TinyCircuits/TinyCircuits-TinyLily_USB-ASL2111/README.md

# TinyCircuits-TinyLily_USB-ASL2111
TinyCircuits TinyLily Mini USB Board, Model ASL2111

For FTDI USB drivers, go to: https://www.ftdichip.com/FTDrivers.htm
