TinyCircuits/TinyCircuits-TinyLily_USB-ASL2111/cad/TinyLily_USB_ASL2111_REV4-DETAILED_DRAWING-PNG.png

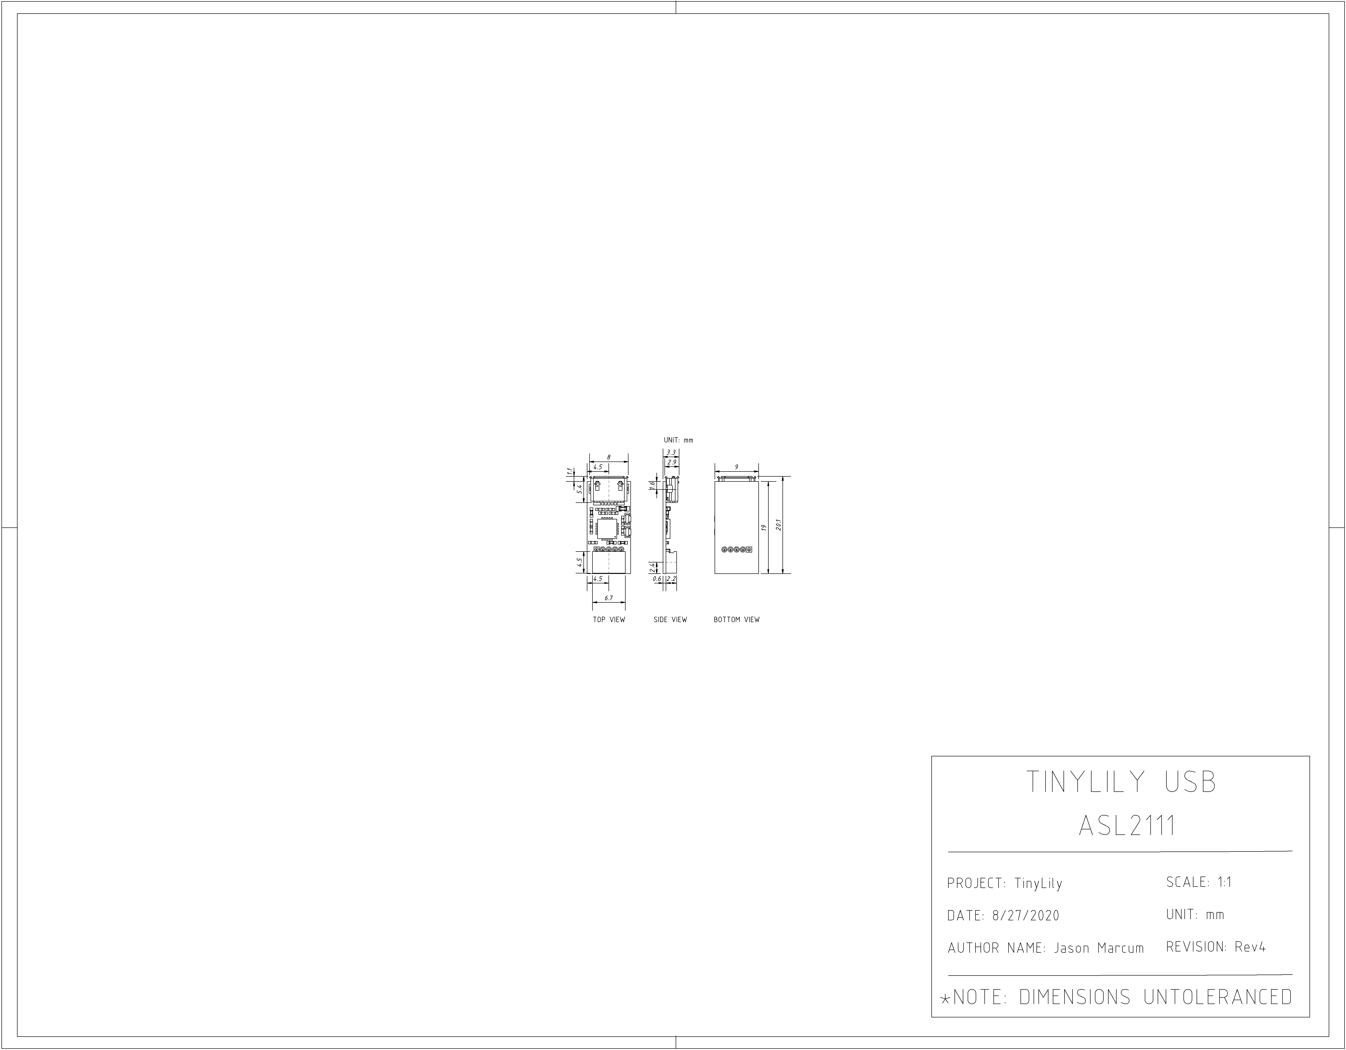
cad/TinyLily_USB_ASL2111_REV4-DETAILED_DRAWING-PNG.png
