TinyCircuits/TinyCircuits-TinyLily_USB-ASL2111/cad/TinyLily_USB_ASL2111_REV4-STL.stl

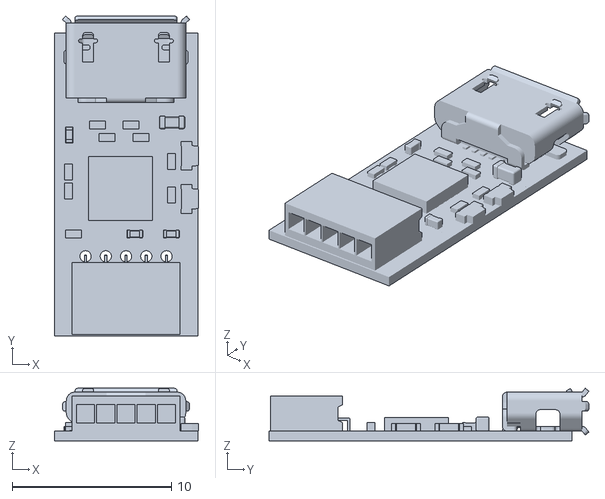
[picture p3: CAD file, 2020-08-28]
cad/TinyLily_USB_ASL2111_REV4-STL.stl
9.06 x 20.1 x 3.30
