TinyCircuits/TinyCircuits-TinyLily_USB-ASL2111/cad/TinyLily_USB_ASL2111_REV4-DETAILED_DRAWING-DXF.dxf

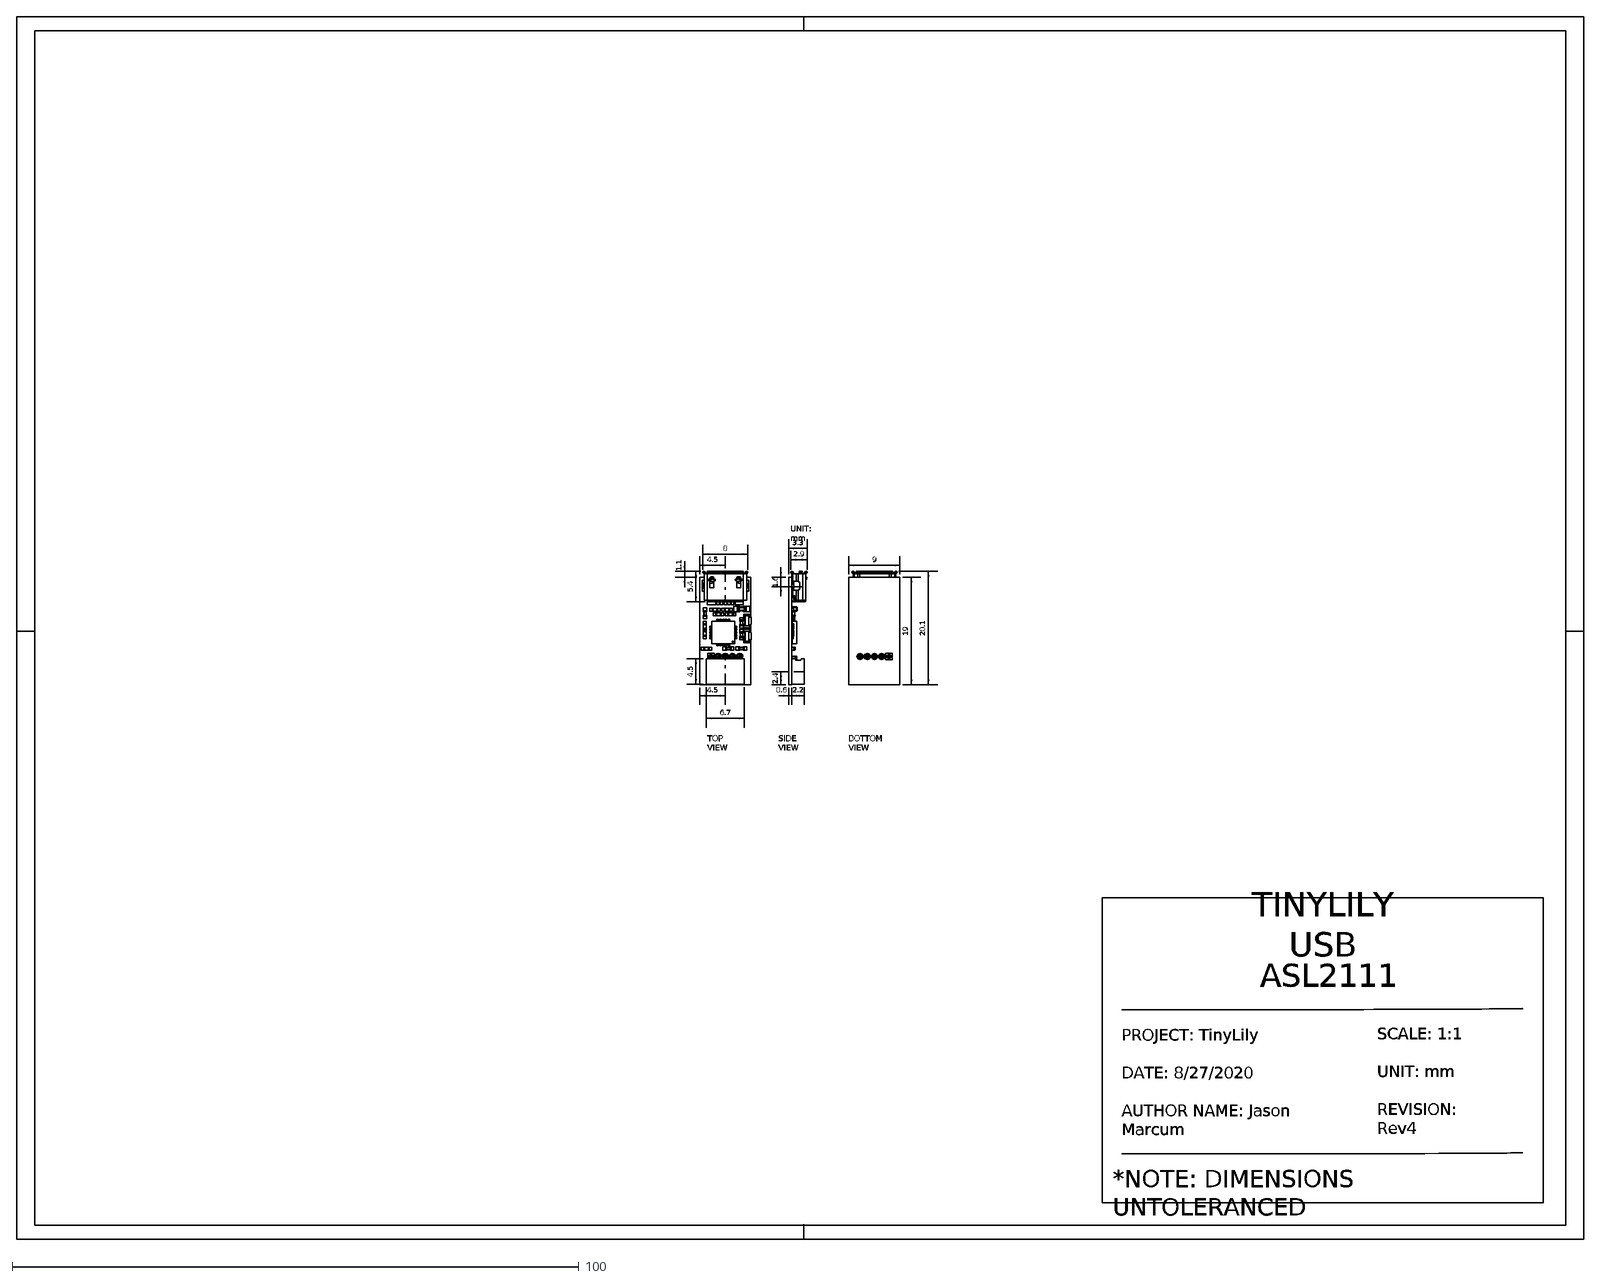
[picture p4: CAD file, 2020-08-28]
cad/TinyLily_USB_ASL2111_REV4-DETAILED_DRAWING-DXF.dxf
*NOTE: DIMENSIONS UNTOLERANCED
4.5
8
5.4
6.7
BOTTOM VIEW
SIDE VIEW
TOP VIEW
1.6
1.1
2.9
2.2
2.4
3.3
0.6
9
19
20.1
UNIT: mm
TINYLILY USB
ASL2111
PROJECT: TinyLily DATE: 8/27/2020 AUTHOR NAME: Jason Marcum
SCALE: 1:1 UNIT: mm REVISION: Rev4
