TinyCircuits/TinyCircuits-TinyLily_USB-ASL2111/design_files/TinyLily_Mini_USB_Rev4.pdf

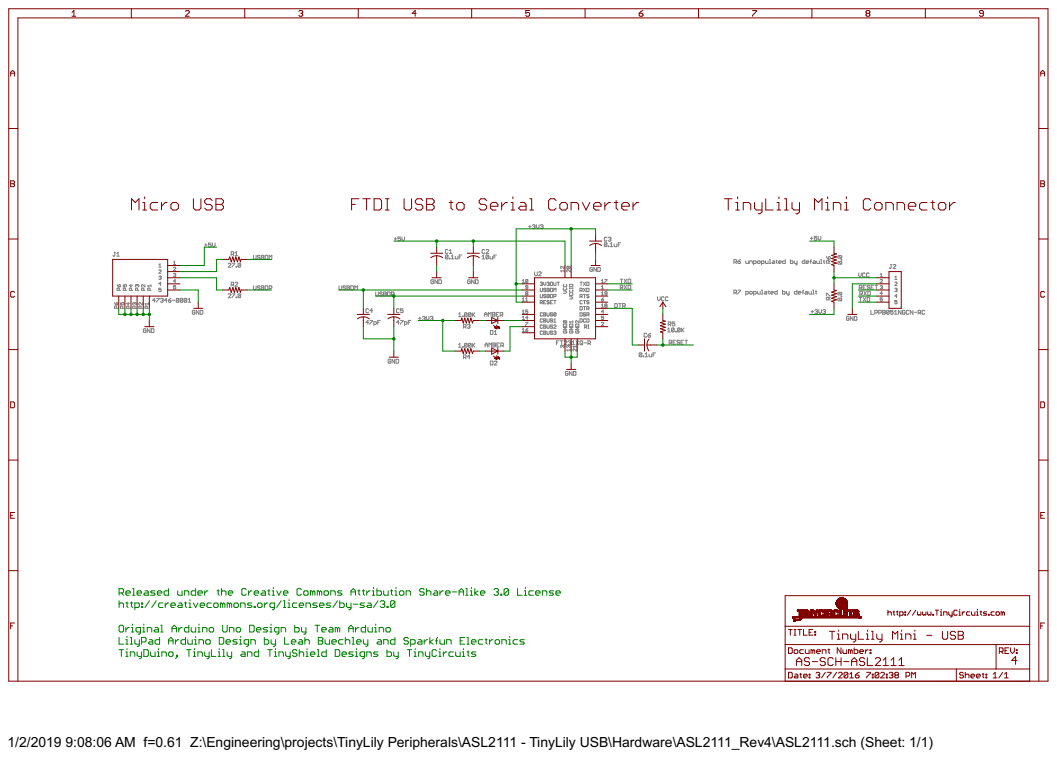
[picture p5: page 1]

1/2/2019 9:08:06 AM f=0.61 Z:\Engineering\projects\TinyLily Peripherals\ASL2111 - TinyLily USB\Hardware\ASL2111_Rev4\ASL2111.sch (Sheet: 1/1)
