TinyCircuits/TinyCircuits-TinyLily_USB-ASL2111/design_files/ASL2111.brd

## EAGLE design design_files/ASL2111.brd (2019-01-02)

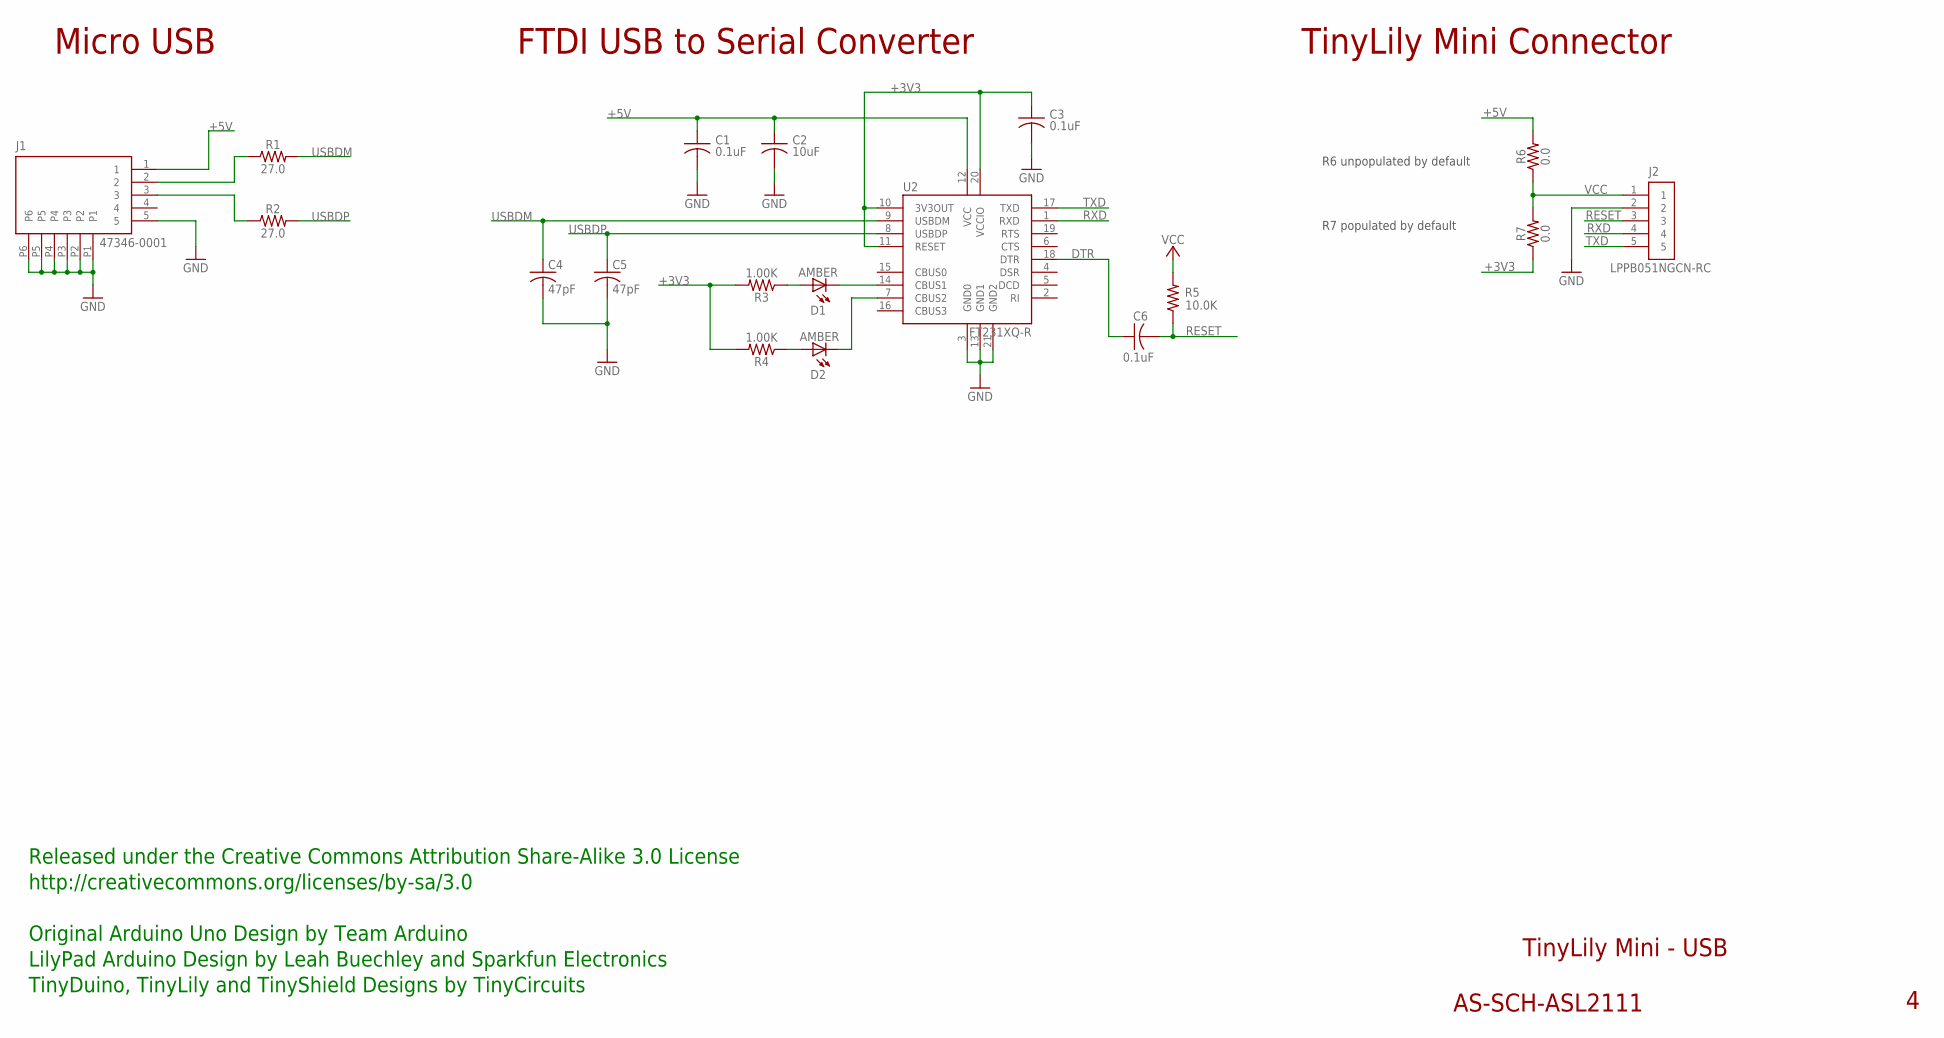
[picture p6: schematic ASL2111.sch]

Parts:
C1: 0.1uF; C0402
C2: 10uF; C0603
C3, C6: 0.1uF; C0402; PARTNO AS-ITM-00008
C4, C5: 47pF; 0402; PARTNO AS-ITM-00241
D1, D2: AMBER; LNJ_LED
J1: 47346-0001; MICRO_USB; PARTNO AS-ITM-00021
J2: LPPB051NGCN-RC; 1X5_.05_RA_TH_RECPT
R1, R2: 27.0; 0402
R3, R4: 1.00K; 0402
R5: 10.0K; 0402
R6, R7: 0.0; 0402
U2: FT231XQ-R; QFN20

Connections:
+3V3: C3.1, R3.2, R4.2, R7.1, U2.10 (3V3OUT), U2.11 (RESET), U2.20 (VCCIO)
+5V: C1.1, C2.1, J1.1, R6.2, U2.12 (VCC)
DTR: C6.1, U2.18 (DTR)
GND: C1.2, C2.2, C3.2, C4.2, C5.2, J1.5, J1.P1, J1.P2, J1.P3, J1.P4, J1.P5, J1.P6, J2.2, U2.3 (GND0), U2.13 (GND1), U2.21 (GND2)
unnamed: D2.C, U2.7 (CBUS2)
unnamed: D1.A, R3.1
unnamed: D2.A, R4.1
unnamed: J1.2, R1.1
unnamed: J1.3, R2.1
unnamed: D1.C, U2.14 (CBUS1)
RESET: C6.2, J2.3, R5.1
RXD: J2.4, U2.1 (RXD)
TXD: J2.5, U2.17 (TXD)
USBDM: C4.1, R1.2, U2.9 (USBDM)
USBDP: C5.1, R2.2, U2.8 (USBDP)
VCC: J2.1, R5.2, R6.1, R7.2

Notes on the sheet:
TinyLily Mini - USB
AS-SCH-ASL2111
R7 populated by default
Micro USB
FTDI USB to Serial Converter
TinyLily Mini Connector
Released under the Creative Commons Attribution Share-Alike 3.0 License
http://creativecommons.org/licenses/by-sa/3.0
Original Arduino Uno Design by Team Arduino
TinyDuino, TinyLily and TinyShield Designs by TinyCircuits
LilyPad Arduino Design by Leah Buechley and Sparkfun Electronics
R6 unpopulated by default

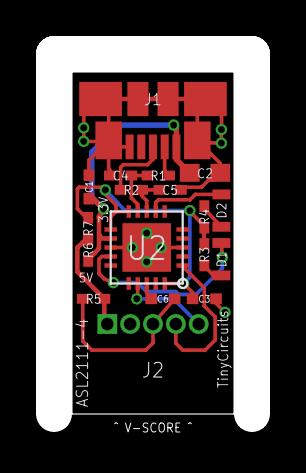
[picture p7: board ASL2111.brd from above]

Board: 2 copper layers, 11.0 x 20.0 mm, 19 parts (0 on the bottom side), 16 nets.

Other parts of the board:
U$1: DOCFIELD-TINYCIRCUITS-PCB
