TinyCircuits/TinyCircuits-TinyLily_USB-ASL2111/(commit log)

2018-12-29 First page commit
    [ASL2111.brd, ASL2111.sch]
2019-01-02 update format
    [ASL2111.brd, ASL2111.sch]
2020-08-28 Add CAD data
    [TinyLily_USB_ASL2111_REV4-DETAILED_DRAWING-DXF.dxf, TinyLily_USB_ASL2111_REV4-STL.stl]
